NilsWittig/mkb_01/README.md

# mkb_01
Mechanical Keyboard 75%

https://www.instructables.com/STM32-As-HID-USB-Keyboard-STM32-Tutorials/

Layed out layout
