NilsWittig/mkb_01/Case/exports/long_side.pdf

# D:/Nextcloud/Things/mkb_01/Case/case_01.scad

0 | 20 | 40 | 60 | 80 | 100 | 120 | 140 | 160 | 180

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
Scale is to calibrate actual printed dimension. Check both X and Y. Measure between tick 0 and last tick
