NilsWittig/mkb_01/jlcpcb_pre_calc.PNG

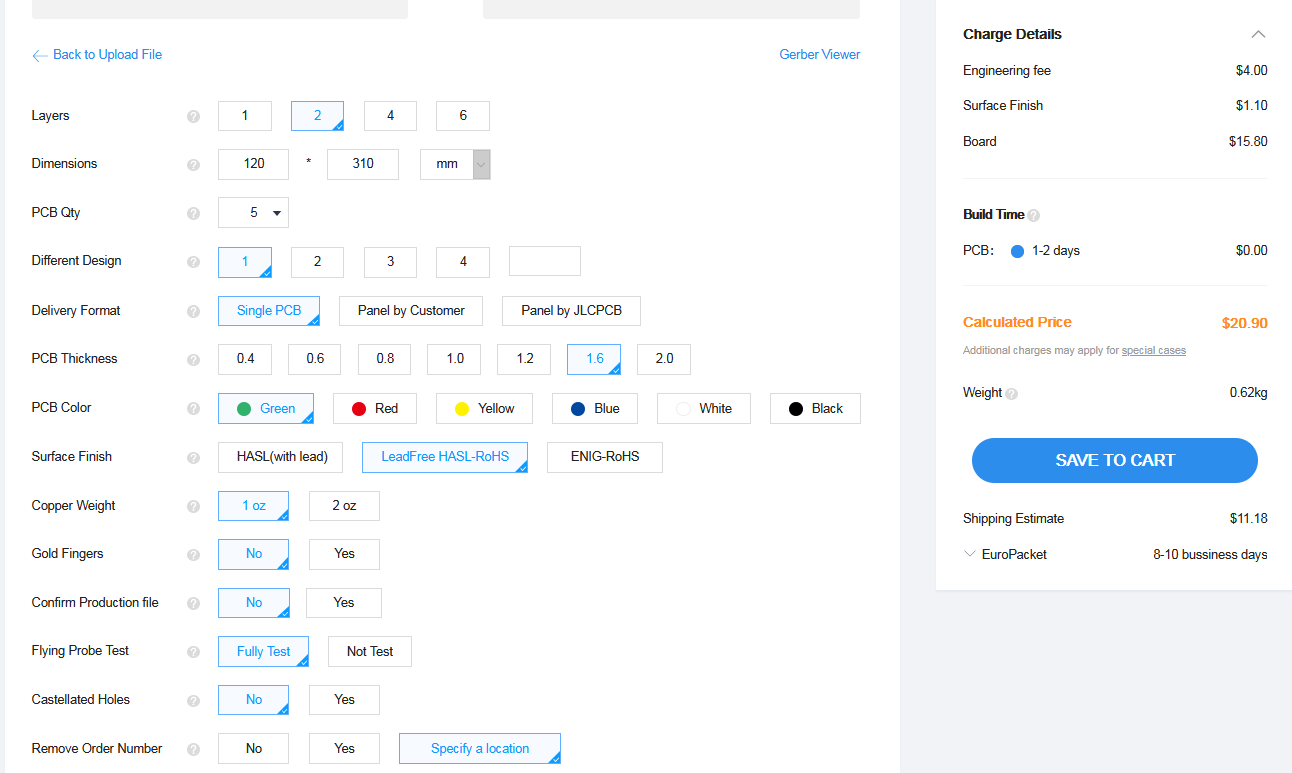
jlcpcb_pre_calc.PNG
