NilsWittig/mkb_01/BOM.ods

Sheet: BOM
 |  | Price | amount | order | order price | min order
MCU | STM32F302C6T6 | 5.14 | 1 | 2 | 10.28 | 1 | https://www.develektro.com/STMICROELECTRONICS-STM32F302C6T6-MCU-32BIT-CORTEX-M4-72MHZ-LQFP-48
USB-C | USB4085-GF-A | 2.2 | 1 | 2 | 4.4 | 1 | https://www.develektro.com/GCT-GLOBAL-CONNECTOR-TECHNOLOGY-USB4085-GF-A-USB-BUCHSE-20-TYP-C-16POS_1
MOSFET | BSP318SH6327XTSA1 | 0.42 | 2 | 5 | 2.1 | 5 | https://www.develektro.com/STMICROELECTRONICS-STN4NF06L-MOSFET-N-KANAL-60V-4A-SOT-223
LDO | LD1117S33TR | 0.72 | 1 | 5 | 3.6 | 5 | https://www.develektro.com/STMICROELECTRONICS-LD1117S33TR-LDO-SPANNREGLER-33V-SMD-1117-SOT-223-3
220R | WR06X221 JTL | 0.01 | 85 | 200 | 2 | 100 | https://www.develektro.com/WALSIN-WR06X221-JTL-DICKSCHICHTWIDERSTAND-220R-5-01W-0603_1
10k | WR06X103 JTL | 0.01 | 5 | 20 | 0.2 | 10 | https://www.develektro.com/WALSIN-WR06X103-JTL-DICKSCHICHTWIDERSTAND-10K-5-01W-0603_1
LED amber | HSMA-C280 | 0.23 | 83 | 100 | 23 | 100 | https://www.develektro.com/BROADCOM-HSMA-C280-LED-GELB-90MCD-592NM-0402
LED red | MCL-S290SRC | 0.17 | 2 | 5 | 0.85 | 5 | https://www.develektro.com/MULTICOMP-PRO-MCL-S290SRC-LED-SMD-0603-SUPER-ROT
Diode rect | MBR0520L | 0.31 | 1 | 2 | 0.62 | 2 | https://www.develektro.com/ON-SEMICONDUCTOR-MBR0520L-SCHOTTKY-DIODE-05A-20V-SMD
10u | CL10A106MQ8NNNC | 0.22 | 15 | 30 | 6.6 | 5 | https://www.develektro.com/SAMSUNG-ELECTRO-MECHANICS-CL10A106MQ8NNNC-KONDENSATOR-10UF-63V-MLCC-0603_1
100n | C0603C104M5RACTU | 0.03 | 6 | 100 | 3 | 10 | https://www.develektro.com/KEMET-C0603C104M5RACTU-KONDENSATOR-01cF-50V-20-X7R-0603
diode sw | 1N4148W RH | 0.03 | 83 | 200 | 6 | 5 | https://www.develektro.com/TAIWAN-SEMICONDUCTOR-1N4148W-RH-KLEINSIGNALDIODE-300V-015A-SOD-123F
Quartz | ABM3-8.000MHZ-D2Y-T | 1 | 1 | 2 | 2 | 1 | https://www.develektro.com/ABRACON-ABM3-8000MHZ-D2Y-T-QUARZ-8MHZ-18PF-SMD
18p | 0603N180J500CT | 0.04 | 2 | 10 | 0.4 | 10 | https://www.develektro.com/MULTICOMP-PRO-MC0603N180J500CT-KONDENSATOR-18PF-50V-5-C0G-NP0-0603
Ferrit | BLM18AG102SN1D | 0.04 | 5 | 20 | 0.8 | 10 | https://www.develektro.com/MURATA-BLM18AG102SN1D-FERRITPERLE-05OHM-04A-25-0603
 |  |  |  |  | 0
 |  |  |  |  | 0
 |  |  |  |  | 65.85
 |  |  |  | actual | 84.27
 |  |  |  |  |  | compatible | https://de.farnell.com/stmicroelectronics/stm32f302c6t6/mcu-32bit-cortex-m4-72mhz-lqfp/dp/2424417?st=stm32f302
 |  |  |  |  |  |  | https://de.farnell.com/stmicroelectronics/stm32f373cbt6/mcu-32bit-cortex-m4f-72mhz-lqfp/dp/2333275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

Sheet: Orders
PCB | self desiged | JLCPCB | 34.82 | 5 | 6.964
Switches | Otemu sky 68g | Pierre | 35 | 1 | 35
Keycaps | Dolch DSA ISO | Keygem | 73.19 | 1 | 73.19
E comps |  | Dev Elekto /Farnell | 84.27 | 2 | 42.135
Stabilizers | Durock V2 screw in smokey | Keygem | 27.5 | 1 | 27.5
Wood |  |  | 0 | 1 | 0
 |  |  |  | total for one | 184.789
artisan | wood cherry spacebar | Keygem | 16.81 | 1
