NilsWittig/mkb_01/MKB_01/mkb_01/mkb_01.kicad_pcb

## KiCad design MKB_01/mkb_01/mkb_01.kicad_pcb (2021-03-19)

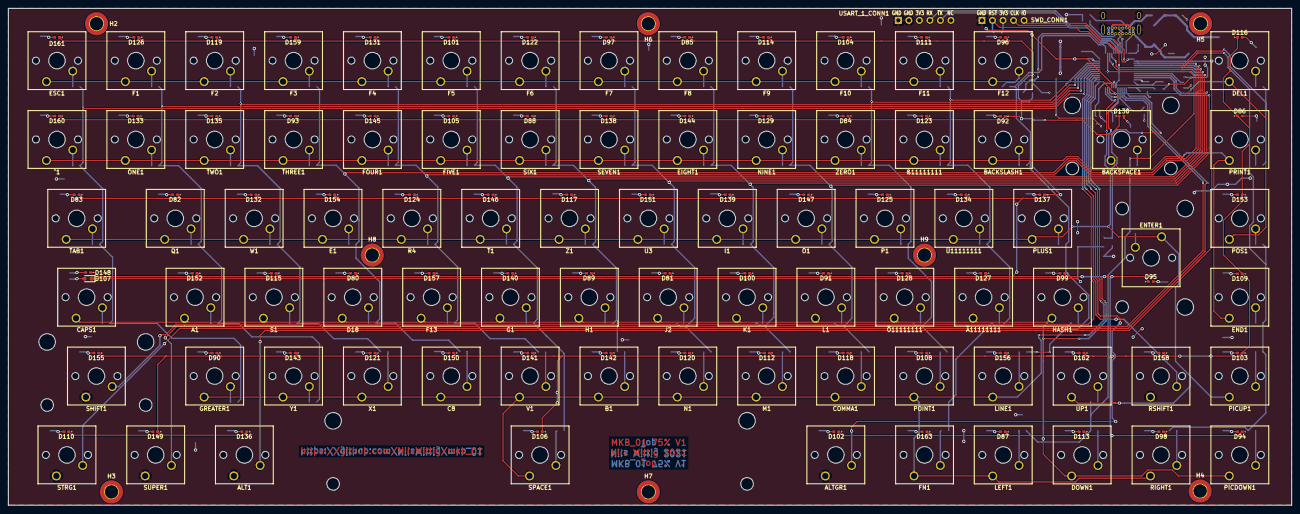
[picture p4: board mkb_01.kicad_pcb from above]

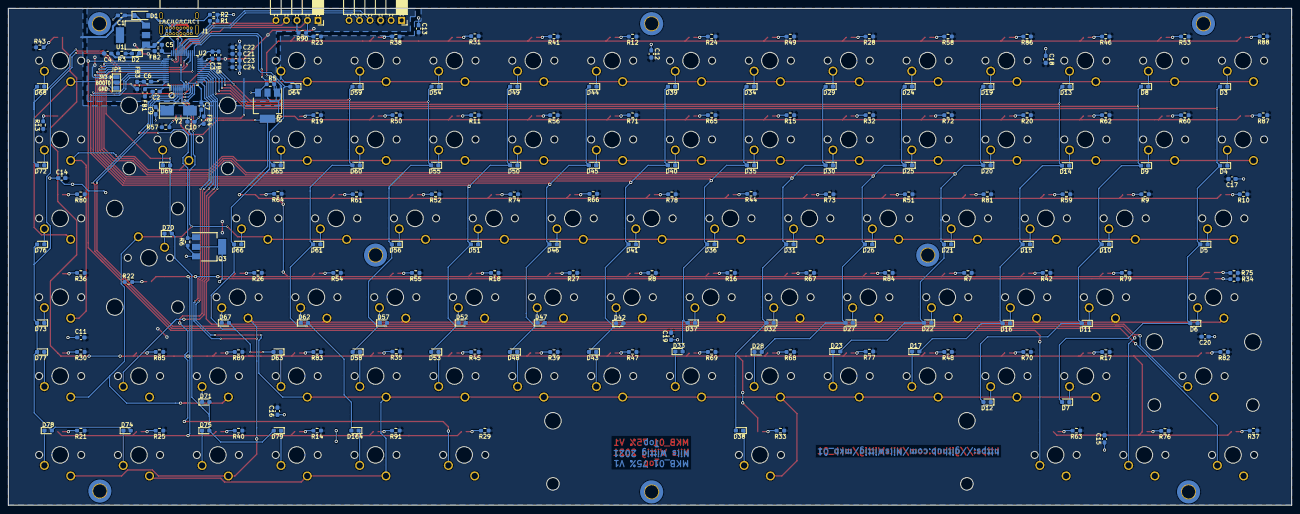
[picture p5: board mkb_01.kicad_pcb from below]

Board: 2 copper layers, 310.0 x 120.0 mm, 381 parts (206 on the bottom side), 214 nets.

Parts:
A1: SW_Push; SW_Cherry_MX_1.00u_PCB
ALT1: SW_Push; SW_Cherry_MX_1.25u_PCB
ALTGR1: SW_Push; SW_Cherry_MX_1.25u_PCB
B1: SW_Push; SW_Cherry_MX_1.00u_PCB
BACKSLASH1: SW_Push; SW_Cherry_MX_1.00u_PCB
BACKSPACE1: SW_Push; SW_Cherry_MX_2.00u_PCB
C1, C2, C3, C5, C6, C7: 100n; C_0603_1608Metric_Pad1.08x0.95mm_HandSolder
C4, C11, C12, C13, C14, C15, C16, C17, C18, C19, C20, C21, C22, C23, C24: 10u; C_0603_1608Metric_Pad1.08x0.95mm_HandSolder
C8: SW_Push; SW_Cherry_MX_1.00u_PCB
C9, C10: 18p; C_0603_1608Metric_Pad1.08x0.95mm_HandSolder
CAPS1: SW_Push; SW_Cherry_MX_1.75u_PCB
COMMA1: SW_Push; SW_Cherry_MX_1.00u_PCB
D1: MBR0520; D_SOD-123
D2, D107: LED red; LED_0603_1608Metric_Pad1.05x0.95mm_HandSolder
D3, D4, D5, D6, D7, D8, D9, D10, D11, D12, D13, D14, D15, D16, D17, D19, D20, D21, D22, D23, D24, D25, D26, D27, D28, D29, D30, D31, D32, D33, D34, D35, D36, D37, D38, D39, D40, D41, D42, D43, D44, D45, D46, D47, D48, D49, D50, D51, D52, D53, D54, D55, D56, D57, D58, D59, D60, D61, D62, D63, D64, D65, D66, D67, D68, D69, D70, D71, D72, D73, D74, D75, D76, D77, D78, D79, D164: 1N4148; D_0603_1608Metric_Pad1.05x0.95mm_HandSolder
D18: SW_Push; SW_Cherry_MX_1.00u_PCB
D80, D81, D82, D83, D84, D85, D86, D87, D88, D89, D90, D91, D92, D93, D94, D95, D96, D97, D98, D99, D100, D101, D102, D103, D104, D105, D106, D108, D109, D110, D111, D112, D113, D114, D115, D116, D117, D118, D119, D120, D121, D122, D123, D124, D125, D126, D127, D128, D129, D130, D131, D132, D133, D134, D135, D136, D137, D138, D139, D140, D141, D142, D143, D144, D145, D146, D147, D148, D149, D150, D151, D152, D153, D154, D155, D156, D157, D158, D159, D160, D161, D162, D163: LED amber; LED_0402_1005Metric_Pad0.77x0.64mm_HandSolder
DEL1: SW_Push; SW_Cherry_MX_1.00u_PCB
DOWN1: SW_Push; SW_Cherry_MX_1.00u_PCB
E1: SW_Push; SW_Cherry_MX_1.00u_PCB
EIGHT1: SW_Push; SW_Cherry_MX_1.00u_PCB
END1: SW_Push; SW_Cherry_MX_1.00u_PCB
ENTER1: SW_Push; SW_Cherry_MX_ISOEnter_PCB
ESC1: SW_Push; SW_Cherry_MX_1.00u_PCB
F1, F2, F3, F4, F5, F6, F7, F8, F9, F10, F11, F12, F13: SW_Push; SW_Cherry_MX_1.00u_PCB
FB1, FB2, FB3, FB4, FB5: Ferrite_Bead_Small; L_0603_1608Metric_Pad1.05x0.95mm_HandSolder
FIVE1: SW_Push; SW_Cherry_MX_1.00u_PCB
FN1: SW_Push; SW_Cherry_MX_1.00u_PCB
FOUR1: SW_Push; SW_Cherry_MX_1.00u_PCB
G1: SW_Push; SW_Cherry_MX_1.00u_PCB
GREATER1: SW_Push; SW_Cherry_MX_1.00u_PCB
H1: SW_Push; SW_Cherry_MX_1.00u_PCB
H2, H3, H4, H5, H6, H7, H8, H9: MountingHole; MountingHole_3.2mm_M3_DIN965_Pad_TopBottom
HASH1: SW_Push; SW_Cherry_MX_1.00u_PCB
I1: SW_Push; SW_Cherry_MX_1.00u_PCB
J1: USB_C_Receptacle_USB2.0; USB_C_Receptacle_GCT_USB4085
J2: SW_Push; SW_Cherry_MX_1.00u_PCB
JP1: SolderJumper_3_Open; SolderJumper-3_P1.3mm_Open_Pad1.0x1.5mm
K1: SW_Push; SW_Cherry_MX_1.00u_PCB
L1: SW_Push; SW_Cherry_MX_1.00u_PCB
LEFT1: SW_Push; SW_Cherry_MX_1.00u_PCB
LINE1: SW_Push; SW_Cherry_MX_1.00u_PCB
M1: SW_Push; SW_Cherry_MX_1.00u_PCB
N1: SW_Push; SW_Cherry_MX_1.00u_PCB
NINE1: SW_Push; SW_Cherry_MX_1.00u_PCB
O1: SW_Push; SW_Cherry_MX_1.00u_PCB
ONE1: SW_Push; SW_Cherry_MX_1.00u_PCB
P1: SW_Push; SW_Cherry_MX_1.00u_PCB
PICDOWN1: SW_Push; SW_Cherry_MX_1.00u_PCB
PICUP1: SW_Push; SW_Cherry_MX_1.00u_PCB
PLUS1: SW_Push; SW_Cherry_MX_1.00u_PCB
POINT1: SW_Push; SW_Cherry_MX_1.00u_PCB
POS1: SW_Push; SW_Cherry_MX_1.00u_PCB
PRINT1: SW_Push; SW_Cherry_MX_1.00u_PCB
Q1: SW_Push; SW_Cherry_MX_1.00u_PCB
Q2, Q3: BSP318; SOT-223-3_TabPin2
R1, R2, R5, R6, R90: 10k; R_0603_1608Metric_Pad0.98x0.95mm_HandSolder
R3, R7, R8, R9, R10, R11, R12, R13, R14, R15, R16, R17, R18, R19, R20, R21, R22, R23, R24, R25, R26, R27, R28, R29, R30, R31, R32, R33, R34, R35, R36, R37, R38, R39, R40, R41, R42, R43, R44, R45, R46, R47, R48, R49, R50, R51, R52, R53, R54, R55, R56, R57, R58, R59, R60, R61, R62, R63, R64, R65, R66, R67, R68, R69, R70, R71, R72, R73, R74, R75, R76, R77, R78, R79, R80, R81, R82, R83, R84, R85, R86, R87, R88, R89, R91: 220; R_0603_1608Metric_Pad0.98x0.95mm_HandSolder
R4: SW_Push; SW_Cherry_MX_1.00u_PCB
RIGHT1: SW_Push; SW_Cherry_MX_1.00u_PCB
RSHIFT1: SW_Push; SW_Cherry_MX_1.00u_PCB
S1: SW_Push; SW_Cherry_MX_1.00u_PCB
SEVEN1: SW_Push; SW_Cherry_MX_1.00u_PCB
SHIFT1: SW_Push; SW_Cherry_MX_2.00u_PCB
SIX1: SW_Push; SW_Cherry_MX_1.00u_PCB
SPACE1: SW_Push; SW_Cherry_MX_6.25u_PCB
STRG1: SW_Push; SW_Cherry_MX_1.25u_PCB
SUPER1: SW_Push; SW_Cherry_MX_1.00u_PCB
SWD_CONN1: Conn_01x05; PinSocket_1x05_P2.54mm_Horizontal
T1: SW_Push; SW_Cherry_MX_1.00u_PCB
TAB1: SW_Push; SW_Cherry_MX_1.50u_PCB
THREE1: SW_Push; SW_Cherry_MX_1.00u_PCB
TWO1: SW_Push; SW_Cherry_MX_1.00u_PCB
U1: LD1117S33TR_SOT223; SOT-223-3_TabPin2
U2: STM32F070CBTx; LQFP-48_7x7mm_P0.5mm
U3: SW_Push; SW_Cherry_MX_1.00u_PCB
UP1: SW_Push; SW_Cherry_MX_1.00u_PCB
USART_1_CONN1: Conn_01x06; PinSocket_1x06_P2.54mm_Horizontal
V1: SW_Push; SW_Cherry_MX_1.00u_PCB
W1: SW_Push; SW_Cherry_MX_1.00u_PCB
X1: SW_Push; SW_Cherry_MX_1.00u_PCB
Y1: SW_Push; SW_Cherry_MX_1.00u_PCB
Y2: Crystal; Crystal_SMD_Abracon_ABM3-2Pin_5.0x3.2mm_HandSoldering
Z1: SW_Push; SW_Cherry_MX_1.00u_PCB
ZERO1: SW_Push; SW_Cherry_MX_1.00u_PCB
^1: SW_Push; SW_Cherry_MX_1.00u_PCB
Ä11111111: SW_Push; SW_Cherry_MX_1.00u_PCB
Ö11111111: SW_Push; SW_Cherry_MX_1.00u_PCB
Ü11111111: SW_Push; SW_Cherry_MX_1.00u_PCB
ß11111111: SW_Push; SW_Cherry_MX_1.00u_PCB

Connections:
3V3: C4.1, C21.2, C22.2, C23.2, C24.2, FB1.1, FB2.1, FB3.1, FB4.1, FB5.1, JP1.1, R3.1, R90.2, SWD_CONN1.3, U1.2, USART_1_CONN1.3
5V: C1.1, C11.2, C12.2, C13.2, C14.2, C15.2, C16.2, C17.2, C18.2, C19.2, C20.2, D1.1, R7.1, R8.1, R9.1, R10.1, R11.1, R12.1, R13.1, R14.1, R15.1, R16.1, R17.1, R18.1, R19.1, R20.1, R21.1, R22.1, R23.1, R24.1, R25.1, R26.1, R27.1, R28.1, R29.1, R30.1, R31.1, R32.1, R33.1, R34.1, R35.1, R36.1, R37.1, R38.1, R39.1, R40.1, R41.1, R42.1, R43.1, R44.1, R45.1, R46.1, R47.1, R48.1, R49.1, R50.1, R51.1, R52.1, R53.1, R54.1, R55.1, R56.1, R57.1, R58.1, R59.1, R60.1, R61.1, R62.1, R63.1, R64.1, R65.1, R66.1, R67.1, R68.1, R69.1, R70.1, R71.1, R72.1, R73.1, R74.1, R75.1, R76.1, R77.1, R78.1, R79.1, R80.1, R81.1, R82.1, R83.1, R84.1, R85.1, R86.1, R87.1, R88.1, R89.1, R91.1, U1.3
BACK_LIGHT: Q2.1, R5.2, U2.29
CAPS_LED_GND: D107.1, Q3.2
CAPS_LIGHT: Q3.1, R6.2, U2.2
GND: ALT1.1, ALTGR1.1, C1.2, C2.2, C3.2, C4.2, C5.2, C6.2, C7.2, C9.2, C10.2, C11.1, C12.1, C13.1, C14.1, C15.1, C16.1, C17.1, C18.1, C19.1, C20.1, C21.1, C22.1, C23.1, C24.1, D2.1, J1.A1, J1.A12, J1.B1, J1.B12, J1.S1, JP1.3, Q2.3, Q3.3, R1.2, R2.1, R5.1, R6.1, RSHIFT1.1, SHIFT1.1, STRG1.1, SUPER1.1, SWD_CONN1.1, U1.1, U2.8, U2.23, U2.35, U2.47, USART_1_CONN1.1, USART_1_CONN1.2
LED_GND: D80.1, D81.1, D82.1, D83.1, D84.1, D85.1, D86.1, D87.1, D88.1, D89.1, D90.1, D91.1, D92.1, D93.1, D94.1, D95.1, D96.1, D97.1, D98.1, D99.1, D100.1, D101.1, D102.1, D103.1, D104.1, D105.1, D106.1, D108.1, D109.1, D110.1, D111.1, D112.1, D113.1, D114.1, D115.1, D116.1, D117.1, D118.1, D119.1, D120.1, D121.1, D122.1, D123.1, D124.1, D125.1, D126.1, D127.1, D128.1, D129.1, D130.1, D131.1, D132.1, D133.1, D134.1, D135.1, D136.1, D137.1, D138.1, D139.1, D140.1, D141.1, D142.1, D143.1, D144.1, D145.1, D146.1, D147.1, D148.1, D149.1, D150.1, D151.1, D152.1, D153.1, D154.1, D155.1, D156.1, D157.1, D158.1, D159.1, D160.1, D161.1, D162.1, D163.1, Q2.2
NRST: R90.1, SWD_CONN1.2, U2.7
unnamed: A1.2, D11.1
unnamed: B1.2, D33.1
unnamed: BACKSLASH1.2, D65.1
unnamed: BACKSPACE1.2, D69.1
unnamed: C2.1, FB1.2, U2.1
unnamed: C3.1, FB5.2, U2.24
unnamed: C5.1, FB2.2, U2.36
unnamed: C6.1, FB3.2, U2.48
unnamed: C7.1, FB4.2, U2.9
unnamed: C8.2, D23.1
unnamed: CAPS1.2, D6.1
unnamed: COMMA1.2, D53.1
unnamed: D1.2, J1.A4, J1.A9, J1.B4, J1.B9
unnamed: D2.2, R3.2
unnamed: D3.1, ESC1.2
unnamed: D4.1, ^1.2
unnamed: D5.1, TAB1.2
unnamed: D7.1, GREATER1.2
unnamed: D8.1, F1.2
unnamed: D9.1, ONE1.2
unnamed: D10.1, Q1.2
unnamed: D12.1, Y1.2
unnamed: D13.1, F2.2
unnamed: D14.1, TWO1.2
unnamed: D15.1, W1.2
unnamed: D16.1, S1.2
unnamed: D17.1, X1.2
unnamed: D18.2, D22.1
unnamed: D19.1, F3.2
unnamed: D20.1, THREE1.2
unnamed: D21.1, E1.2
unnamed: D24.1, F4.2
unnamed: D25.1, FOUR1.2
unnamed: D26.1, R4.2
unnamed: D27.1, F13.2
unnamed: D28.1, V1.2
unnamed: D29.1, F5.2
unnamed: D30.1, FIVE1.2
unnamed: D31.1, T1.2
unnamed: D32.1, G1.2
unnamed: D34.1, F6.2
unnamed: D35.1, SIX1.2
unnamed: D36.1, Z1.2
unnamed: D37.1, H1.2
unnamed: D38.1, SPACE1.2
unnamed: D39.1, F7.2
unnamed: D40.1, SEVEN1.2
unnamed: D41.1, U3.2
unnamed: D42.1, J2.2
unnamed: D43.1, N1.2
unnamed: D44.1, F8.2
unnamed: D45.1, EIGHT1.2
unnamed: D46.1, I1.2
unnamed: D47.1, K1.2
unnamed: D48.1, M1.2
unnamed: D49.1, F9.2
unnamed: D50.1, NINE1.2
unnamed: D51.1, O1.2
unnamed: D52.1, L1.2
unnamed: D54.1, F10.2
unnamed: D55.1, ZERO1.2
unnamed: D56.1, P1.2
unnamed: D57.1, Ö11111111.2
unnamed: D58.1, POINT1.2
unnamed: D59.1, F11.2
unnamed: D60.1, ß11111111.2
unnamed: D61.1, Ü11111111.2
unnamed: D62.1, Ä11111111.2
unnamed: D63.1, LINE1.2
unnamed: D64.1, F12.2
unnamed: D66.1, PLUS1.2
unnamed: D67.1, HASH1.2
unnamed: D68.1, DEL1.2
unnamed: D70.1, ENTER1.2
unnamed: D71.1, UP1.2
unnamed: D72.1, PRINT1.2
unnamed: D73.1, END1.2
unnamed: D74.1, RIGHT1.2
unnamed: D75.1, DOWN1.2
unnamed: D76.1, POS1.2
unnamed: D77.1, PICUP1.2
unnamed: D78.1, PICDOWN1.2
unnamed: D79.1, LEFT1.2
unnamed: D80.2, R7.2
unnamed: D81.2, R8.2
unnamed: D82.2, R9.2
unnamed: D83.2, R10.2
unnamed: D84.2, R11.2
unnamed: D85.2, R12.2
unnamed: D86.2, R13.2
unnamed: D87.2, R14.2
unnamed: D88.2, R15.2
unnamed: D89.2, R16.2
unnamed: D90.2, R17.2
unnamed: D91.2, R18.2
unnamed: D92.2, R19.2
unnamed: D93.2, R20.2
unnamed: D94.2, R21.2
unnamed: D95.2, R22.2
unnamed: D96.2, R23.2
unnamed: D97.2, R24.2
unnamed: D98.2, R25.2
unnamed: D99.2, R26.2
unnamed: D100.2, R27.2
unnamed: D101.2, R28.2
unnamed: D102.2, R29.2
unnamed: D103.2, R30.2
unnamed: D104.2, R31.2
unnamed: D105.2, R32.2
unnamed: D106.2, R33.2
unnamed: D107.2, R34.2
unnamed: D108.2, R35.2
unnamed: D109.2, R36.2
unnamed: D110.2, R37.2
unnamed: D111.2, R38.2
unnamed: D112.2, R39.2
unnamed: D113.2, R40.2
unnamed: D114.2, R41.2
unnamed: D115.2, R42.2
unnamed: D116.2, R43.2
unnamed: D117.2, R44.2
unnamed: D118.2, R45.2
unnamed: D119.2, R46.2
unnamed: D120.2, R47.2
unnamed: D121.2, R48.2
unnamed: D122.2, R49.2
unnamed: D123.2, R50.2
unnamed: D124.2, R51.2
unnamed: D125.2, R52.2
unnamed: D126.2, R53.2
unnamed: D127.2, R54.2
unnamed: D128.2, R55.2
unnamed: D129.2, R56.2
unnamed: D130.2, R57.2
unnamed: D131.2, R58.2
unnamed: D132.2, R59.2
unnamed: D133.2, R60.2
unnamed: D134.2, R61.2
unnamed: D135.2, R62.2
unnamed: D136.2, R63.2
unnamed: D137.2, R64.2
unnamed: D138.2, R65.2
unnamed: D139.2, R66.2
unnamed: D140.2, R67.2
unnamed: D141.2, R68.2
unnamed: D142.2, R69.2
unnamed: D143.2, R70.2
unnamed: D144.2, R71.2
unnamed: D145.2, R72.2
unnamed: D146.2, R73.2
unnamed: D147.2, R74.2
unnamed: D148.2, R75.2
unnamed: D149.2, R76.2
unnamed: D150.2, R77.2
unnamed: D151.2, R78.2
unnamed: D152.2, R79.2
unnamed: D153.2, R80.2
unnamed: D154.2, R81.2
unnamed: D155.2, R82.2
unnamed: D156.2, R83.2
unnamed: D157.2, R84.2
unnamed: D158.2, R85.2
unnamed: D159.2, R86.2
unnamed: D160.2, R87.2
unnamed: D161.2, R88.2
unnamed: D162.2, R89.2
unnamed: D163.2, R91.2
unnamed: D164.1, FN1.2
unnamed: J1.A5, R1.1
unnamed: J1.B5, R2.2
unnamed: JP1.2, U2.44
OSC_IN: C9.1, U2.5, Y2.1
OSC_OUT: C10.1, U2.6, Y2.2
PA0: DEL1.1, ESC1.1, F1.1, F2.1, F3.1, F4.1, F5.1, F6.1, F7.1, F8.1, F9.1, F10.1, F11.1, F12.1, POS1.1, U2.10
PA1: BACKSLASH1.1, BACKSPACE1.1, EIGHT1.1, END1.1, FIVE1.1, FOUR1.1, NINE1.1, ONE1.1, PRINT1.1, SEVEN1.1, SIX1.1, THREE1.1, TWO1.1, U2.11, ZERO1.1, ^1.1, ß11111111.1
PA2: E1.1, ENTER1.1, I1.1, O1.1, P1.1, PICUP1.1, PLUS1.1, Q1.1, R4.1, T1.1, TAB1.1, U2.12, U3.1, UP1.1, W1.1, Z1.1, Ü11111111.1
PA3: A1.1, CAPS1.1, D18.1, DOWN1.1, F13.1, G1.1, H1.1, HASH1.1, J2.1, K1.1, L1.1, PICDOWN1.1, S1.1, U2.13, Ä11111111.1, Ö11111111.1
PA4: B1.1, C8.1, COMMA1.1, FN1.1, GREATER1.1, LEFT1.1, LINE1.1, M1.1, N1.1, POINT1.1, RIGHT1.1, SPACE1.1, U2.14, V1.1, X1.1, Y1.1
PA5: ALTGR1.2, U2.15
PA6: RSHIFT1.2, U2.16
PA7: SHIFT1.2, U2.17
PA15: ALT1.2, U2.38
PB0: D3.2, D4.2, D5.2, D6.2, D7.2, U2.18
PB1: D8.2, D9.2, D10.2, D11.2, D12.2, U2.19
PB2: D13.2, D14.2, D15.2, D16.2, D17.2, U2.20
PB3: D19.2, D20.2, D21.2, D22.2, D23.2, U2.39
PB4: D24.2, D25.2, D26.2, D27.2, D28.2, U2.40
PB5: D29.2, D30.2, D31.2, D32.2, D38.2, U2.41
PB6: D33.2, D34.2, D35.2, D36.2, D37.2, U2.42
PB7: D39.2, D40.2, D41.2, D42.2, D43.2, U2.43
PB8: D44.2, D45.2, D46.2, D47.2, D48.2, U2.45
PB9: D49.2, D50.2, D51.2, D52.2, D53.2, U2.46
PB10: D54.2, D55.2, D56.2, D57.2, D58.2, U2.21
PB11: D59.2, D60.2, D61.2, D62.2, D164.2, U2.22
PB12: D63.2, D64.2, D65.2, D66.2, D67.2, U2.25
PB13: D69.2, D70.2, D71.2, D75.2, D79.2, U2.26
PB14: D73.2, D74.2, D76.2, D77.2, D78.2, U2.27
PB15: D68.2, D72.2, U2.28
PC14: STRG1.2, U2.3
PC15: SUPER1.2, U2.4
SWDCLK: SWD_CONN1.4, U2.37
SWDIO: SWD_CONN1.5, U2.34
USART_1_RX: U2.31, USART_1_CONN1.4
USART_1_TX: U2.30, USART_1_CONN1.5
USB_DM: J1.A7, J1.B7, U2.32
USB_DP: J1.A6, J1.B6, U2.33
