NilsWittig/mkb_01/cubemx_setup.PNG

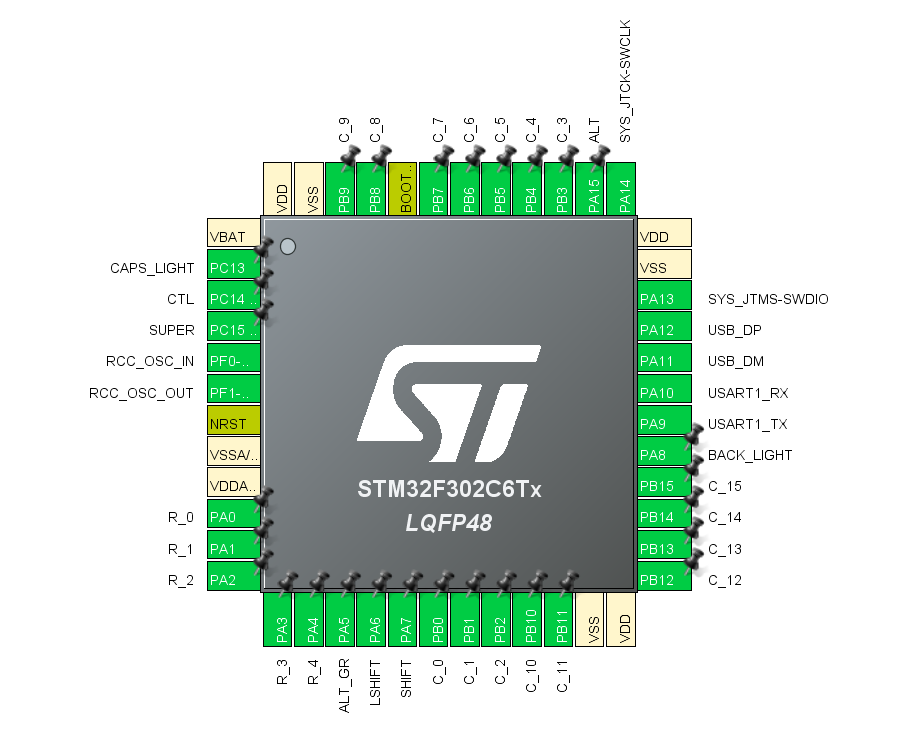
cubemx_setup.PNG
