NilsWittig/mkb_01/firmware/fw_L053C6T6/Src/main.c

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
/* Includes ------------------------------------------------------------------*/
#include "main.h"
#include "usb_device.h"

/* USER CODE BEGIN Includes */

/*
 * in Middlewares/ST/STM32_USB_Device_Library/class/HID/Inc/usbd_hid.h
 * changed HID_MOUSE_REPORT_DESC_SIZE from 74U to 63U
 *
 * in Middlewares/ST/STM32_USB_Device_Library/class/HID/Inc/usbd_hid.c
 * changed nInterfaceProtocol in USBD_HID_CfgFSDesc from 2 to 1
 * changed data in HID_MOUSE_ReportDesc to be a keybord
 *
 */


/* USER CODE END Includes */

/* USER CODE BEGIN PD */
#define PRESS_REPORT_SIZE 8
/* USER CODE END PD */

TIM_HandleTypeDef htim2;
TIM_HandleTypeDef htim6;
TIM_HandleTypeDef htim21;
TIM_HandleTypeDef htim22;

UART_HandleTypeDef huart1;

/* USER CODE BEGIN PV */
extern USBD_HandleTypeDef hUsbDeviceFS;


typedef struct
{
	uint8_t MODIFIER;
	uint8_t RESERVED;
	uint8_t KEYCODE1;
	uint8_t KEYCODE2;
	uint8_t KEYCODE3;
	uint8_t KEYCODE4;
	uint8_t KEYCODE5;
	uint8_t KEYCODE6;
}subKeyBoard;

subKeyBoard keyBoardHIDsub = {0,0,0,0,0,0,0,0};

/* USER CODE END PV */

void SystemClock_Config(void);
static void MX_GPIO_Init(void);
static void MX_USART1_UART_Init(void);
static void MX_TIM2_Init(void);
static void MX_TIM6_Init(void);
static void MX_TIM21_Init(void);
static void MX_TIM22_Init(void);
/**
  * @brief  The application entry point.
  * @retval int
  */
int main(void)
{
  /* MCU Configuration--------------------------------------------------------*/

  /* Reset of all peripherals, Initializes the Flash interface and the Systick. */
  HAL_Init();

  /* Configure the system clock */
  SystemClock_Config();

  /* Initialize all configured peripherals */
  MX_GPIO_Init();
  MX_USART1_UART_Init();
  MX_USB_DEVICE_Init();
  MX_TIM2_Init();
  MX_TIM6_Init();
  MX_TIM21_Init();
  MX_TIM22_Init();
  /* USER CODE BEGIN 2 */

  char msg[100] = "L053C6T6 fw\n";
  uint32_t cnt = 0;

  uint8_t press_report[PRESS_REPORT_SIZE] = {0};
  press_report[2] = 7; // 'd'

  //HAL_Delay(2000);

  HAL_UART_Transmit(&huart1, (uint8_t *) msg, strlen(msg), 1000);


  HAL_GPIO_WritePin(CAPS_LIGHT_GPIO_Port, CAPS_LIGHT_Pin, GPIO_PIN_SET);

  HAL_GPIO_WritePin(GPIOA, BACK_LIGHT_Pin, GPIO_PIN_RESET);
  HAL_GPIO_WritePin(GPIOA, R_0_Pin|R_1_Pin|R_2_Pin|R_3_Pin|R_4_Pin, GPIO_PIN_RESET);
  uint8_t caps_state =  HAL_GPIO_ReadPin(GPIOB, C_0_Pin);
  uint8_t one_state =  HAL_GPIO_ReadPin(GPIOB, C_1_Pin);
  uint8_t ctl_state =  HAL_GPIO_ReadPin(GPIOC, CTL_Pin);

  /* USER CODE END 2 */

  /* Infinite loop */
  /* USER CODE BEGIN WHILE */
  while (1)
  {

	  HAL_Delay(1000);
	  caps_state =  HAL_GPIO_ReadPin(GPIOB, C_0_Pin);
	  one_state =  HAL_GPIO_ReadPin(GPIOB, C_1_Pin);
	  ctl_state =  HAL_GPIO_ReadPin(GPIOC, CTL_Pin);
	  sprintf(msg, "Alive %u, Caps: %u, C_1: %u, CTL: %u\n", cnt++, caps_state, one_state, ctl_state);
	  HAL_UART_Transmit(&huart1, (uint8_t *) msg, strlen(msg), 1000);

	  HAL_GPIO_TogglePin(CAPS_LIGHT_GPIO_Port, CAPS_LIGHT_Pin);


	  if(!ctl_state){

		  keyBoardHIDsub.KEYCODE2=0x06;  // Press C key
		  USBD_HID_SendReport(&hUsbDeviceFS,&keyBoardHIDsub,sizeof(keyBoardHIDsub));
		  HAL_Delay(50); 		       // Press all key for 50 milliseconds
		  keyBoardHIDsub.KEYCODE2=0x00;  // Release C key
		  USBD_HID_SendReport(&hUsbDeviceFS,&keyBoardHIDsub,sizeof(keyBoardHIDsub));

	  }

    /* USER CODE END WHILE */

    /* USER CODE BEGIN 3 */
  }
  /* USER CODE END 3 */
}

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
