NilsWittig/mkb_01/(commit log)

2021-03-11 put project in repo
    [BOM.ods, mkb_01.kicad_pcb, mkb_01.sch]
2021-03-11 added FN key fixed layout
    [mkb_01.kicad_pcb, mkb_01.sch]
2021-03-12 changed quartz, finished placing and layers, some routing done
    [mkb_01.kicad_pcb, mkb_01.sch]
2021-03-13 routing somewhat finished
    [mkb_01.kicad_pcb]
2021-03-14 fixed silkscreen markings, exported and checked jlcpcb
    [mkb_01-B_Cu.gbr, mkb_01-B_Mask.gbr, mkb_01-B_Paste.gbr, mkb_01-B_SilkS.gbr, mkb_01-Edge_Cuts.gbr, mkb_01-F_Cu.gbr, mkb_01-F_Mask.gbr, mkb_01-F_Paste.gbr]
2021-03-15 added ferrit beads and optimized pcb a bit
    [mkb_01.kicad_pcb, mkb_01.sch]
2021-03-16 change diode direction to read from column rather than rows, added some more caps for the mcu, updated BOM
    [BOM.ods, mkb_01.kicad_pcb, mkb_01.sch]
2021-03-16 routing optimizations
    [mkb_01.kicad_pcb]
2021-03-27 parts arrived added orders
    [BOM.ods]
2021-03-28 started designing case
    [case_01.scad]
2021-03-30 soldered and tested mcu
2021-06-25 device name changed, problems with pullups
2023-01-24 some schematic rework
    [mkb_01.kicad_sch, mkb_01.sch]
