NilsWittig/mkb_01/(notices)

Notices in the files:
firmware/fw_L053C6T6/Inc/main.h:
© Copyright (c) 2021 STMicroelectronics.
All rights reserved.
This software component is licensed by ST under Ultimate Liberty license
(C) COPYRIGHT STMicroelectronics *****END OF FILE
