NilsWittig/mkb_01/layout75.jpg

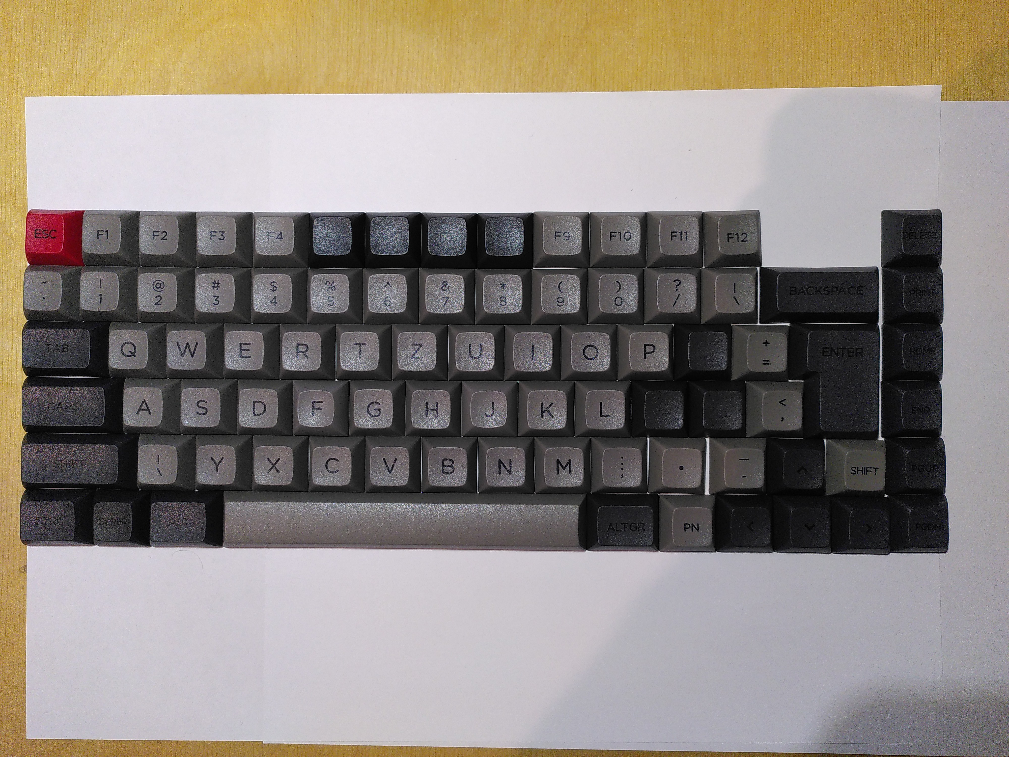
[picture p1: layout75.jpg]
layout75.jpg
